xuan361/RISC32-SC/rtl/ControlUnit.v

module ControlUnit(
    input  wire[16:0]  op,   //17位操作码
    input wire zero, // ALU的zero输出,作为条件，zero=0为真，zero=1为假
    input wire divReady,    // 除法模块是否就绪，默认为0

    // 控制信号
    output reg[1:0]    m2reg, //决定写回寄存器文件来源。 0：把ALU的运算结果传回，1：把数据存储器的数据传回 2:把立即数左移后的数据传回 
    output reg[1:0]    PCsrc,    // 控制程序计数器（PC）的更新来源，通常用于分支或跳转操作。PCsrc=0为不跳转，PCsrc=1为跳转PC=PC+offset, PCsrc=2为跳转PC=result=immExt + A_data(ALU的运算结果)
    output reg    wmem, //控制存储器的写操作, 0为读，1为写
    output reg[2:0] memc,    //控制写一字节还是两个字节，memc=0为 1字节（无符号），memc=1为 2字节（无符号）, memc=2为1个字(32位，4个字节), memc=3为 1字节（有符号）, memc=4为 2字节（有符号）
    output reg[4:0]  aluc, //控制 ALU 的操作类型，通常用于选择 ALU 的加法、减法、逻辑运算等操作。共16种，前10种是计算，后六种是逻辑运算（作为条件实现跳转）
    output reg    alusrc1,  // 控制 ALU 的操作数A输入来源，通常用于选择 ALU 的操作数。0为寄存器的数（add),1为currentAddress
    output reg    alusrc2,  // 控制 ALU 的操作数B输入来源，通常用于选择 ALU 的操作数。0为寄存器的数（add),1为立即数（addi)
    output reg    wreg,  // 控制寄存器的写操作  1为写回，0为不写回
    output reg    jal,   // 控制跳转指令的跳转类型，通常用于选择跳转指令的类型。1为跳转，0为不跳转
    output reg PCHold     // 控制PC的更新，0为更新，1为不更新
);
    // 操作码中间变量  
    wire [6:0] opcode;
    wire [2:0] function3;
    wire [6:0] function7;

    assign opcode = op[6:0];
    assign function3 = op[9:7];
    assign function7 = op[16:10];
    
/* 
    // 默认情况：
            m2reg = 2'b00;
            PCsrc = 2'b00;
            wmem = 1'b0;
            memc = 3'b000;
            aluc = 5'b00000;
            alusrc1 = 1'b0;
            alusrc2 = 1'b0;
            wreg = 1'b1;    // 写入寄存器
            jal = 1'b0;
            PCHold = 1'b0;
 */

    always @(*) begin
        case(opcode)
            // R型指令: 包括加法、减法、逻辑运算、移位运算 --> rs1 和 rs2的运算 --> aluc 10种算术运算 + 6种逻辑运算 + 8种乘除运算
            // R型指令: 包括加法、减法、逻辑运算、移位运算 --> rs1 和 rs2的运算
            7'b0110011: begin
                alusrc1 = 1'b0;
                alusrc2 = 1'b0;
                wreg = 1'b1;    // 写入寄存器rd
                case(function3)  
                    3'b000: begin
                        if(function7 == 7'h0) aluc = 5'b00000; // add
                        else if(function7 == 7'b0100000) aluc = 5'b00001;   // sub
                        else if(function7 == 7'h1) aluc = 5'b10000;  // mul
                        else aluc = 5'b00000; // 优化：补充无效function7的默认值（避免锁存）
                    end
                    3'b001: begin
                        if(function7 == 7'h0) aluc = 5'b00010;    // sll
                        else if(function7 == 7'h1) aluc = 5'b10001;    // mulh
                        else aluc = 5'b00000; // 优化：补充默认值
                    end
                    3'b010: begin
                        if(function7 == 7'h0) aluc = 5'b00011;     // slt
                        else if(function7 == 7'h1) aluc = 5'b10010;    // mulhsu
                        else aluc = 5'b00000; // 优化：补充默认值
                    end
                    3'b011: begin
                        if(function7 == 7'h0) aluc = 5'b00100;     // sltu
                        else if(function7 == 7'h1) aluc = 5'b10011;    // mulhu
                        else aluc = 5'b00000; // 优化：补充默认值
                    end
                    3'b100: begin
                        if(function7 == 7'h0) aluc = 5'b00101;     // xor
                        else if(function7 == 7'h1) aluc = 5'b10100;    // div
                        else aluc = 5'b00000; // 优化：补充默认值
                    end
                    3'b101: begin
                        if(function7 == 7'b0000000) aluc = 5'b00110; // srl
                        else if (function7 == 7'b0100000) aluc = 5'b00111;   // sra
                        else if(function7 == 7'h1) aluc = 5'b10101;    // divu
                        else aluc = 5'b00000; // 优化：补充默认值
                    end
                    3'b110: begin
                        if(function7 == 7'b0000000) aluc = 5'b01000;     // or
                        else if(function7 == 7'h1) aluc = 5'b10110;    // rem
                        else aluc = 5'b00000; // 优化：补充默认值
                    end
                    3'b111: begin
                        if(function7 == 7'b0000000) aluc = 5'b01001;     // and
                        else if(function7 == 7'h1) aluc = 5'b10111;    // remu
                        else aluc = 5'b00000; // 优化：补充默认值
                    end
                    default: aluc = 5'b00000; // 优化：补充无效function3的默认值
                endcase
                if(aluc >= 5'd20 && aluc < 5'd24) begin
                    if(!divReady) PCHold = 1'b1;
                    else PCHold = 1'b0;
                end
                else begin
                    PCHold = 1'b0;
                end

                m2reg = 2'b00;
                PCsrc = 2'b00;
                wmem = 1'b0;
                memc = 3'b000;
                jal = 1'b0;

            end 

            // I型指令:立即数的运算 --> alusrc2, aluc
            7'b0010011: begin
                alusrc1 = 1'b0;
                alusrc2 = 1'b1;
                wreg = 1'b1;    // 写入寄存器rd
                case(function3)
                    3'b000: aluc = 5'b00000; //addi
                    3'b001: aluc = 5'b00010;     //slli
                    3'b010: aluc = 5'b00011;     //slti
                    3'b011: aluc = 5'b00100;     //sltui
                    3'b100: aluc = 5'b00101;     //xori
                    3'b101: begin // 优化：用begin-end包裹，补充else
                        if(function7 == 7'b0000000) aluc = 5'b00110; // srli
                        else if (function7 == 7'b0100000) aluc = 5'b00111;   // srai
                        else aluc = 5'b00000; // 优化：补充无效function7的默认值
                    end
                    3'b110: aluc = 5'b01000;     //ori
                    3'b111: aluc = 5'b01001;     //andi
                    default: aluc = 5'b00000; // 优化：补充无效function3的默认值
                endcase

                m2reg = 2'b00;
                PCsrc = 2'b00;
                wmem = 1'b0;
                memc = 3'b000;
                jal = 1'b0;
                PCHold = 1'b0;
            end

            // I型指令: load指令 --> wreg, m2reg, memc
            7'b0000011: begin
                wreg = 1'b1;
                m2reg = 2'b01;
                case(function3)
                    3'b000: memc = 3'b011;   // lb 有符号
                    3'b001: memc = 3'b100;   // lh 有符号
                    3'b010: memc = 3'b010;   // lw
                    3'b100: memc = 3'b000;   // lbu 无符号
                    3'b101: memc = 3'b001;   // lhu 无符号
                    // --- 修复：添加 default 分支 ---
                    default: memc = 3'b010; // 或者 3'bxxx，或一个默认的错误值
                endcase

                PCsrc = 2'b00;
                wmem = 1'b0;
                aluc = 5'b00000;
                alusrc1 = 1'b0;
                alusrc2 = 1'b1;
                jal = 1'b0;
                PCHold = 1'b0;
            end

            // I型指令: jair --> jal,wreg,alusrc2,aluc,PCsrc
            7'b1100111: begin
                jal = 1'b1; //实现返回地址保存到rd
                wreg = 1'b1;  // 写入寄存器
                alusrc1 = 1'b0;
                alusrc2 = 1'b1;
                aluc = 5'b00000;
                PCsrc = 2'b10;  //跳转到rs1 + immExt

                m2reg = 2'b00;
                wmem = 1'b0;
                memc = 3'b000;
                PCHold = 1'b0;
            end

            // S型指令: store指令 --> wmem, memc
            7'b0100011: begin
                wmem = 1'b1;
                wreg = 1'b0;    // 不写入寄存器
                case(function3)
                    3'b000: memc = 3'b000;   // sb
                    3'b001: memc = 3'b001;   // sh
                    3'b010: memc = 3'b010;   // sw
                    // --- 修复：添加 default 分支 ---
                    default: memc = 3'b010; // 或者 3'bxxx
                endcase

                m2reg = 2'b00;
                PCsrc = 2'b00;
                aluc = 5'b00000;
                alusrc1 = 1'b0;
                alusrc2 = 1'b1;
                jal = 1'b0;
                PCHold = 1'b0;
            end


            // B型指令:条件跳转指令 zero--> alusrc2, aluc(6种), PCsrc
            7'b1100011: begin
                alusrc1 = 1'b0;
                alusrc2 = 1'b0;  // rs1 和 rs2 参与比较运算
                wreg = 1'b0;    // 不写入寄存器
                case(function3) 
                    3'b000: aluc = 5'b01010;  //beq
                    3'b001: aluc = 5'b01011;  //bne
                    3'b100: aluc = 5'b01100;  //blt
                    3'b101: aluc = 5'b01101;  //bge
                    3'b110: aluc = 5'b01110;  //bltu
                    3'b111: aluc = 5'b01111;  //bgeu
                    default: aluc = 5'b01010; // 默认为 beq 或一个无效值
                endcase
                if(!zero) PCsrc = 2'b01;  //跳转
                else  PCsrc = 2'b00;  //不跳转

                m2reg = 2'b00;
                wmem = 1'b0;
                memc = 3'b000;
                jal = 1'b0;
                PCHold = 1'b0;
            end
            
            // U型指令
            7'b0110111: begin   //lui --> m2reg, jal 左移后的立即数写到rd中
                m2reg = 2'b10;
                jal = 1'b0;
                wreg = 1'b1;    // 写入寄存器

                PCsrc = 2'b00;
                wmem = 1'b0;
                memc = 3'b000;
                aluc = 5'b00000;
                alusrc1 = 1'b0;
                alusrc2 = 1'b0;
                PCHold = 1'b0;
            end

            7'b0010111: begin   //auipc --> alusrc1, m2reg, jal 当前PC值与左移后的立即数相加
                m2reg = 2'b00;
                alusrc1 = 1'b1;
                alusrc2 = 1'b1;
                wreg = 1'b1;    // 写入寄存器

                PCsrc = 2'b00;
                wmem = 1'b0;
                memc = 3'b000;
                aluc = 5'b00000;
                jal = 1'b0;
                PCHold = 1'b0;

            end

            // J型指令：jal --> jal, wreg, alusrc2
            7'b1101111: begin   //jal --> jal, wreg, alusrc2, aluc
                jal = 1'b1;     //实现返回地址保存到rd
                wreg = 1'b1;    // 写入寄存器
                PCsrc = 2'b01;  //跳转到当前PC值 + immExt

                m2reg = 2'b00;
                wmem = 1'b0;
                memc = 3'b000;
                aluc = 5'b00000;
                alusrc1 = 1'b0;
                alusrc2 = 1'b0;
                PCHold = 1'b0;
            end

            default: begin
                m2reg = 2'b00;
                PCsrc = 2'b00;
                wmem = 1'b0;
                memc = 3'b000;
                aluc = 5'b00000;
                alusrc1 = 1'b0;
                alusrc2 = 1'b0;
                wreg = 1'b0;  // 无效指令不写寄存器
                jal = 1'b0;
                PCHold = 1'b0;
            end


        endcase

    end



endmodule
