xuan361/RISC32-SC/(commit log)

2025-09-04 ALU模块完成
2025-09-04 更新图片来源
2025-09-09 控制单元完成
2025-09-09 内存模块完成
2025-09-10 指令寄存器和Rom模块创建和更新
2025-09-17 多路选择器模块修改
2025-09-17 修改设计图，移除DM模块，移除参考选择器模块
2025-09-17 timer模块设计和仿真完成
2025-09-17 立即数扩展模块完成
2025-09-17 Ram和寄存器组模块完成
2025-09-23 新增数码管模块
2025-10-13 ALU设计逻辑完备，仿真通过
2025-10-13 删除参考代码
2025-10-14 添加汇编模块，ROM静态下载
2025-10-14 修改一些错误
2025-10-14 CPU可以运转
2025-10-21 收发部件模块的逻辑更新，待仿真
2025-11-04 修改ALU带符号加减法，修正immgen符号扩展逻辑，添加通信文件和动态下载逻辑
2025-11-04 shamt定义修正
2025-11-04 给Ram添加片选信号，Uart.v的状态寄存器拆分
2025-11-06 修改无法将数据存入Uart通信外设的发送数据寄存器，导致uart_tx发送时始终为低电平；修改：删去临时发送数据寄存器。
2025-11-11 仿真通过，上板子失败
2025-11-18 串口发送功能实现，修改Ram寄存器数目（1024->256）和约束文件时钟周期(20ns ->200ns)
2025-11-18 收发仿真成功，上板失败
2025-12-23 PC,开发板通信实现
2025-12-25 汇编指令（流水灯，时钟显示，UART数据接收）全部测试成功，主要修改Gpio文件(数码管和led灯显示）
2026-01-11 32位CPU功能完备实现
2026-01-11 更新目录结构和说明
